turcoale/Bancas2.0/Rough BeagleBone Black.JPG

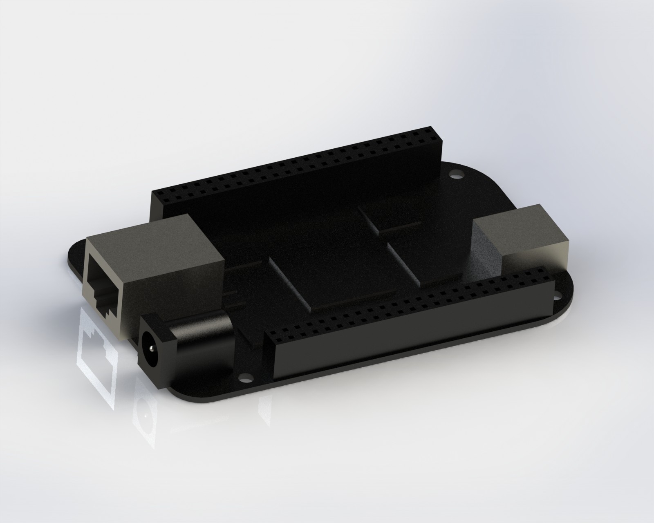
Rough BeagleBone Black.JPG
