turcoale/Bancas2.0/LCD.png

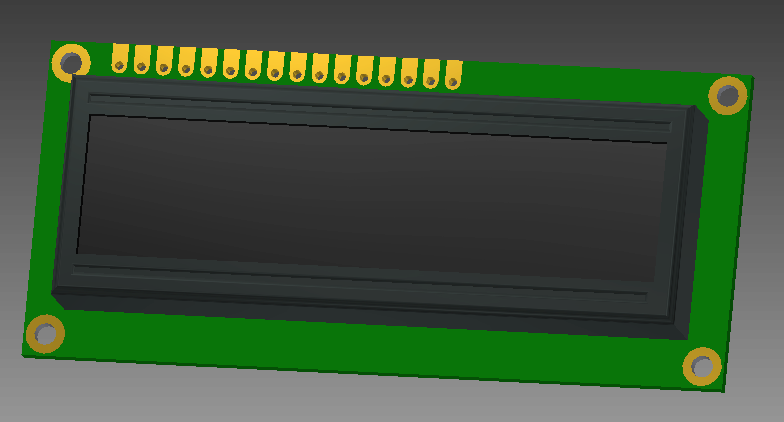
LCD.png
