turcoale/Bancas2.0/Sin título 1.odt

# Modernización y reacondicionamiento de bancas:

Se reemplazará las placas principales de banca por unidades similares pero con tecnología mas actualizada, esto permitirá no sólo realizar un intercambio directo ante eventual falla, sino que también incorporar nuevas funcionalidades para futuras ampliaciones.

Las nuevas placas “MiniPc” poseen un procesador de mayor capacidades a las actuales, puertos usb de propósito general, puertos ethernet, salida de video HDMI, lo cual nos permitirá mas adelante mejorar la topología de conexión de las bancas, ademas de la posibilidad a futuro de incorporar una pantalla tactil de 7” …...
