turcoale/Bancas2.0/166.jpg

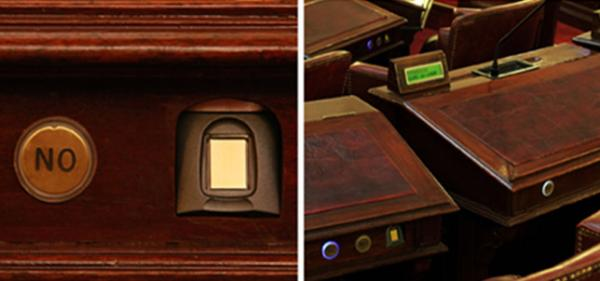
166.jpg
