turcoale/Bancas2.0/BBB.png

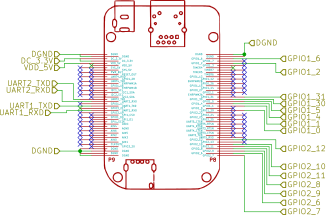
BBB.png
