turcoale/Bancas2.0/biometrico.jpg

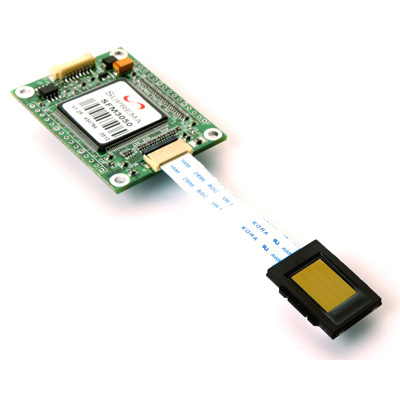
biometrico.jpg
