turcoale/Bancas2.0/butaca.jpg

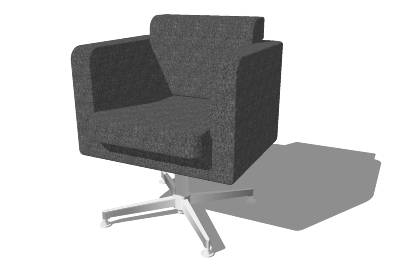
butaca.jpg
