turcoale/Bancas2.0/mic.jpg

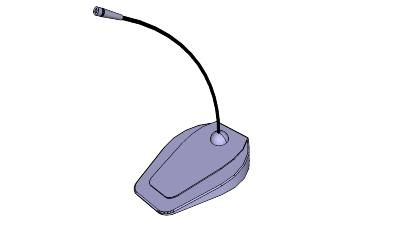
mic.jpg
