turcoale/Bancas2.0/PP.JPG

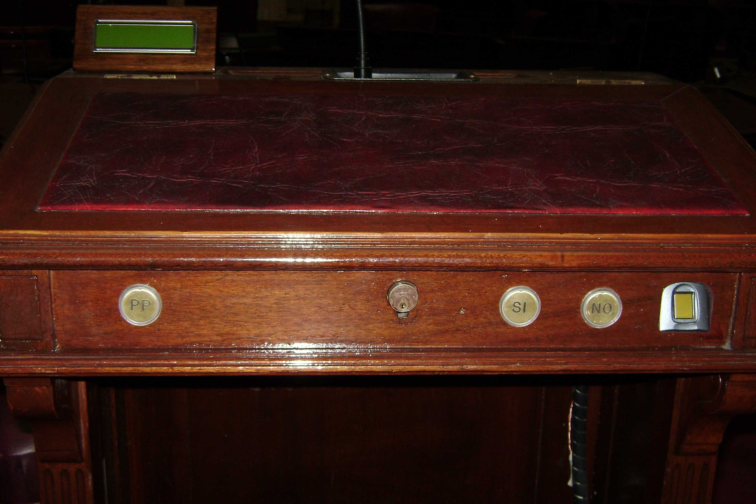
PP.JPG
