turcoale/Bancas2.0/PP.png

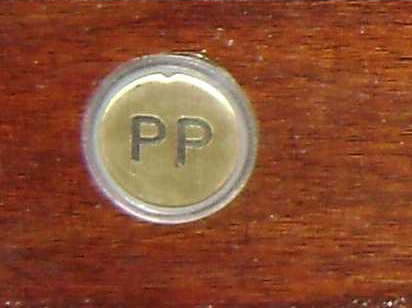
PP.png
