turcoale/Bancas2.0/pulsadores.png

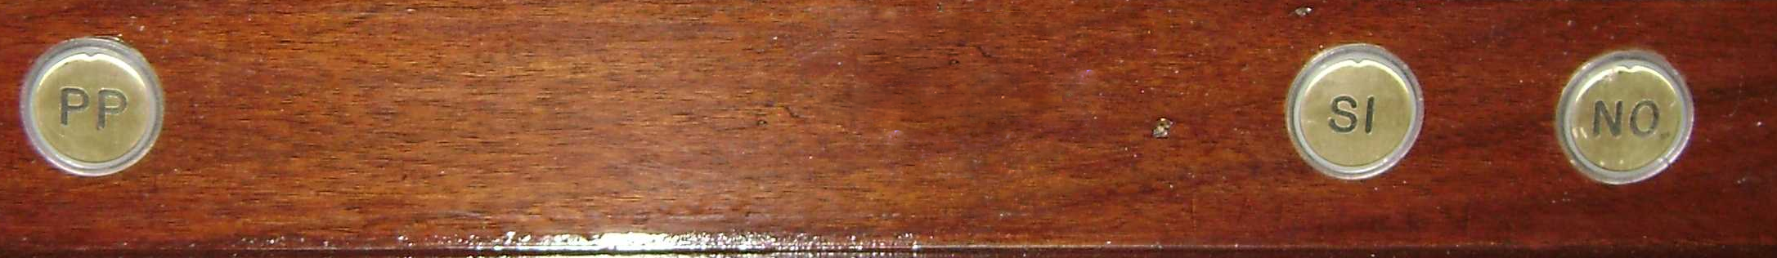
pulsadores.png
