turcoale/Bancas2.0/server.jpg

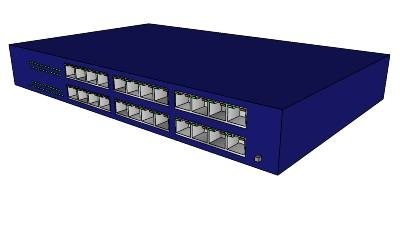
server.jpg
