turcoale/Bancas2.0/Sistema.png

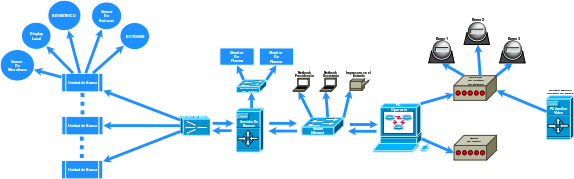
Sistema.png
