turcoale/Bancas2.0/materiales.ods

Insumo | Cantidad | Costos a Enero 2014 | aclaraciones
Placas miniPc BeagleBone Black | 10 | 800
Biometricos Suprema SFM3050 | 4
Placa cape interface | 10
Display 7” | 1 | 2500
Gabinete acrilico o similar para beaglebone | 10 |  | (consultar en acrimec)
cables |  |  | (mejorar el cableado de bancas)
