turcoale/Bancas2.0/diseñopcb/cape/beaglebonecape.pdf

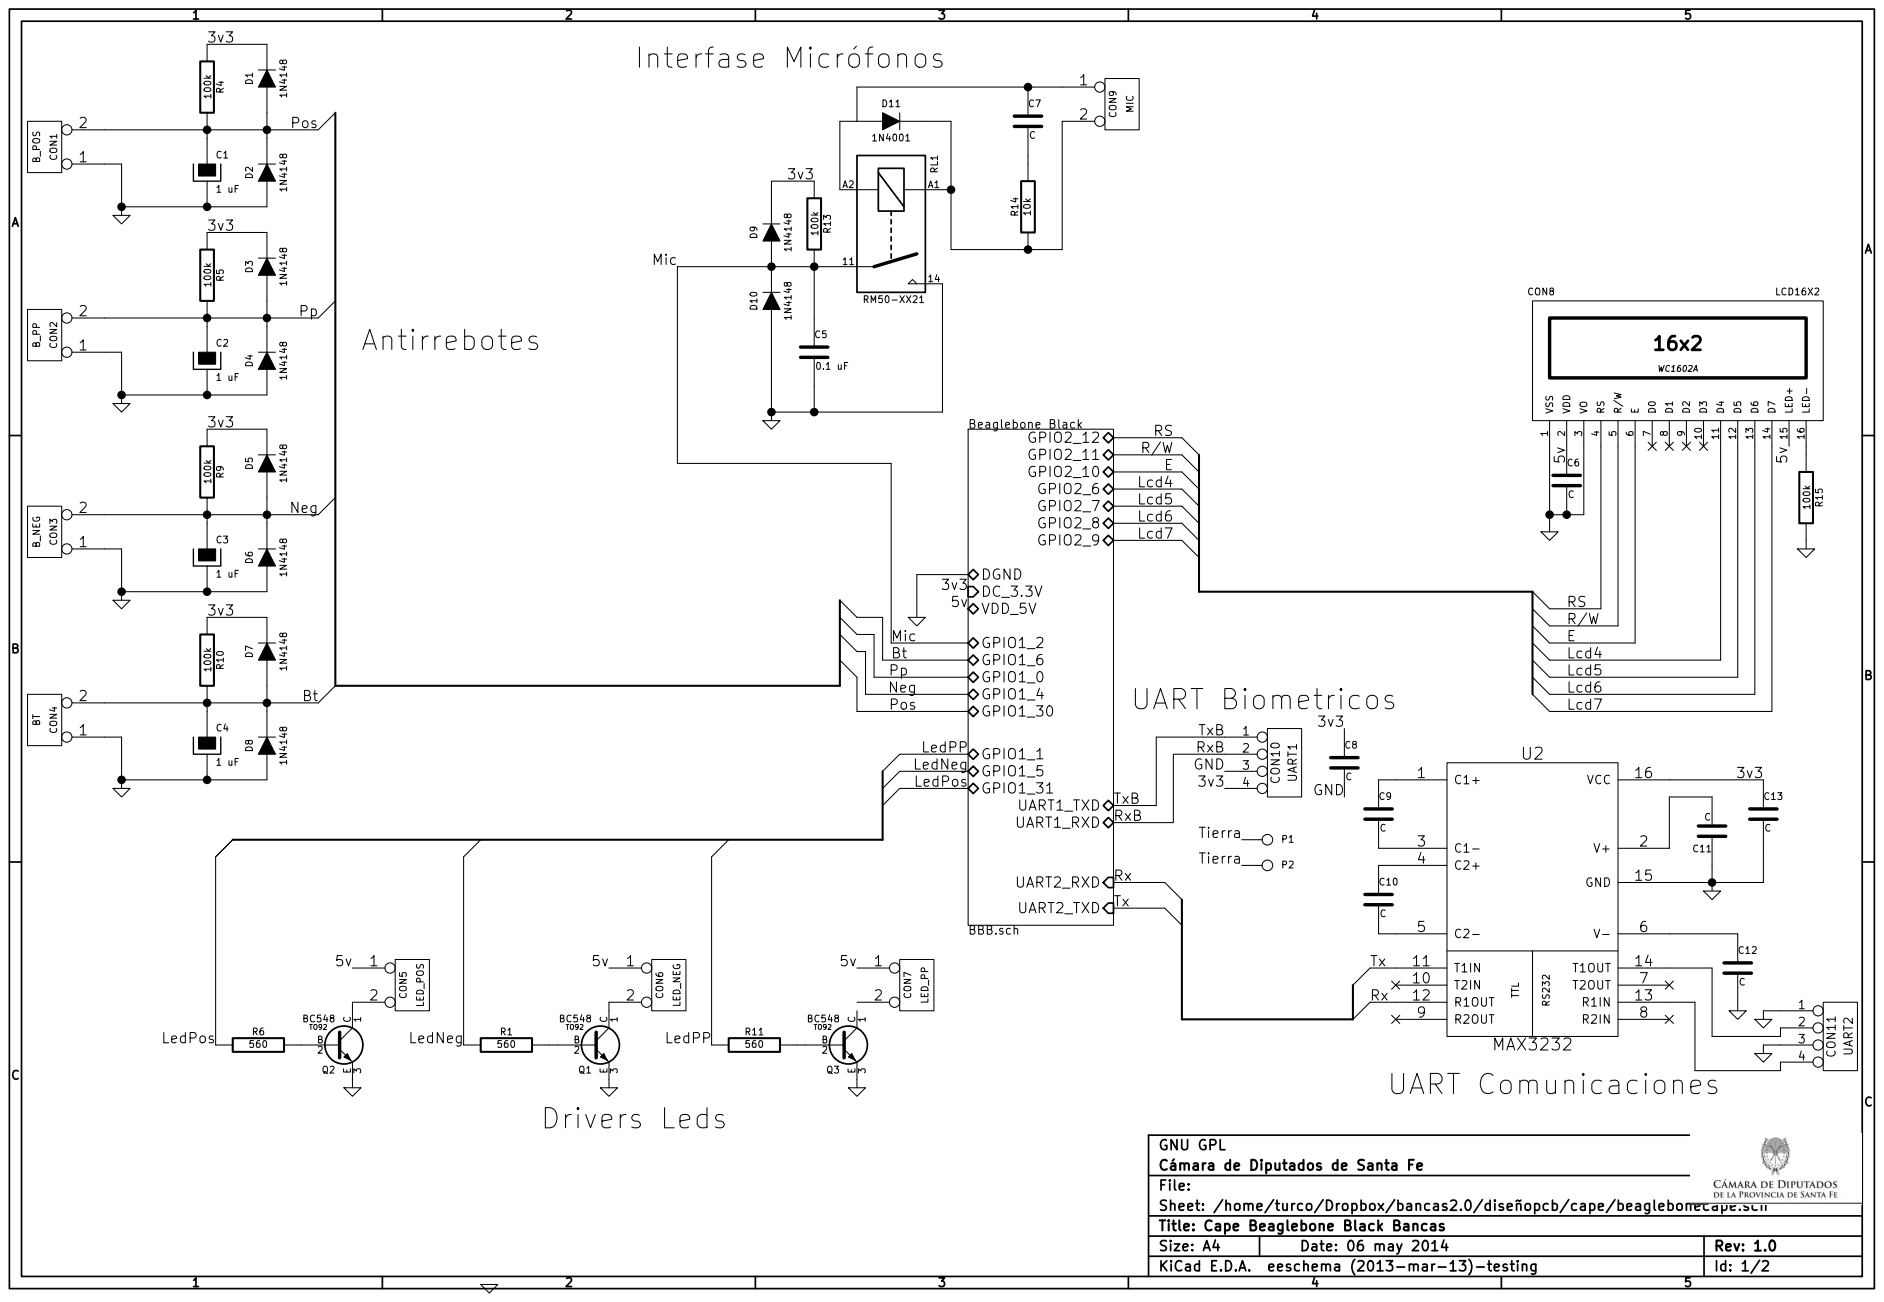
[picture p16: page 1]

9 D3 10 D4 11 D5 12 D6 13 D7 14 LED+ 15 LED- 16 CON8 LCD16X2 WC1602A UART Biometricos

C11C Beaglebone Black BBB.sch DGND

Lcd4
Lcd5
Lcd6
Lcd7

C GNU GPL Cámara de Diputados de Santa Fe

Sheet: /home/turco/Dropbox/bancas2.0/diseñopcb/cape/beaglebonecape.sch File: Title: Cape Beaglebone Black Bancas

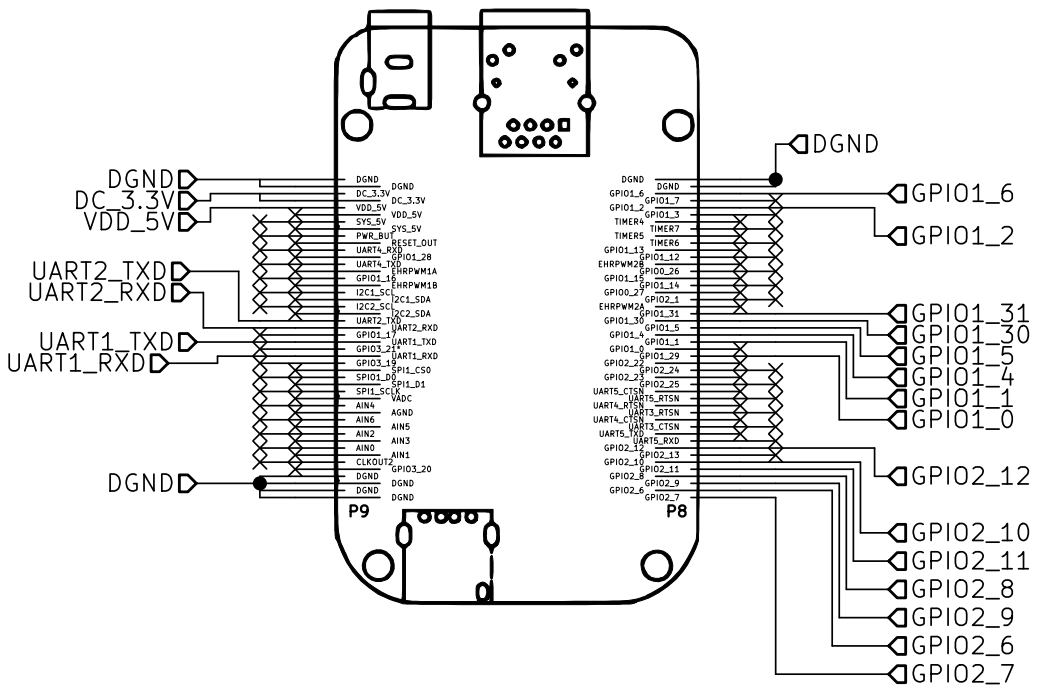
[picture p17: page 2]

C GNU GPL Cámara de Diputados de Santa Fe Sheet: BBB.sch File: Title: Cape Beaglebone Black Bancas
