turcoale/Bancas2.0/diseñopcb/cape/BBB-Beaglebone Black.pdf

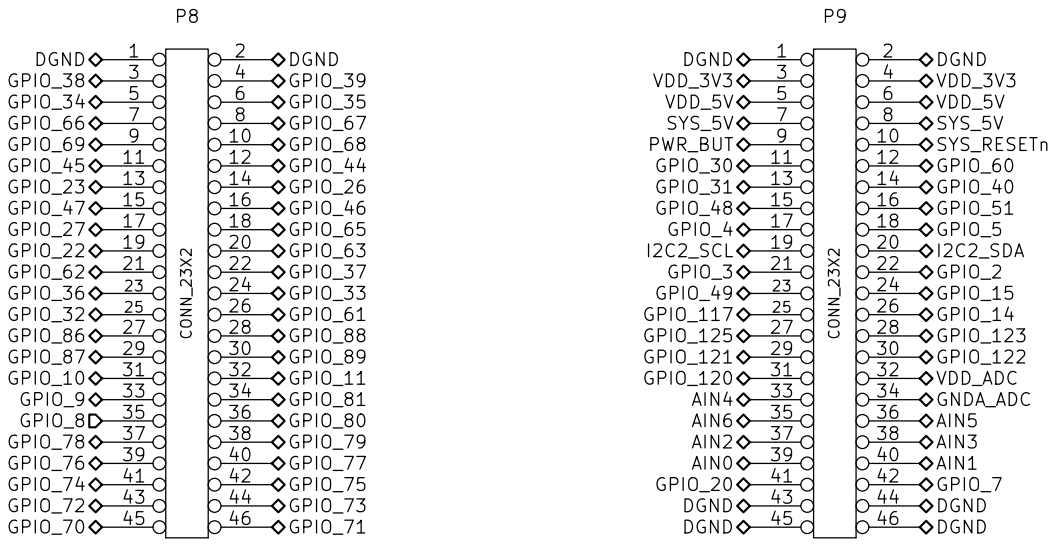
[picture p18: page 1]
