turcoale/Bancas2.0/diseñopcb/cape/beaglebonecape-B_Cu.pdf

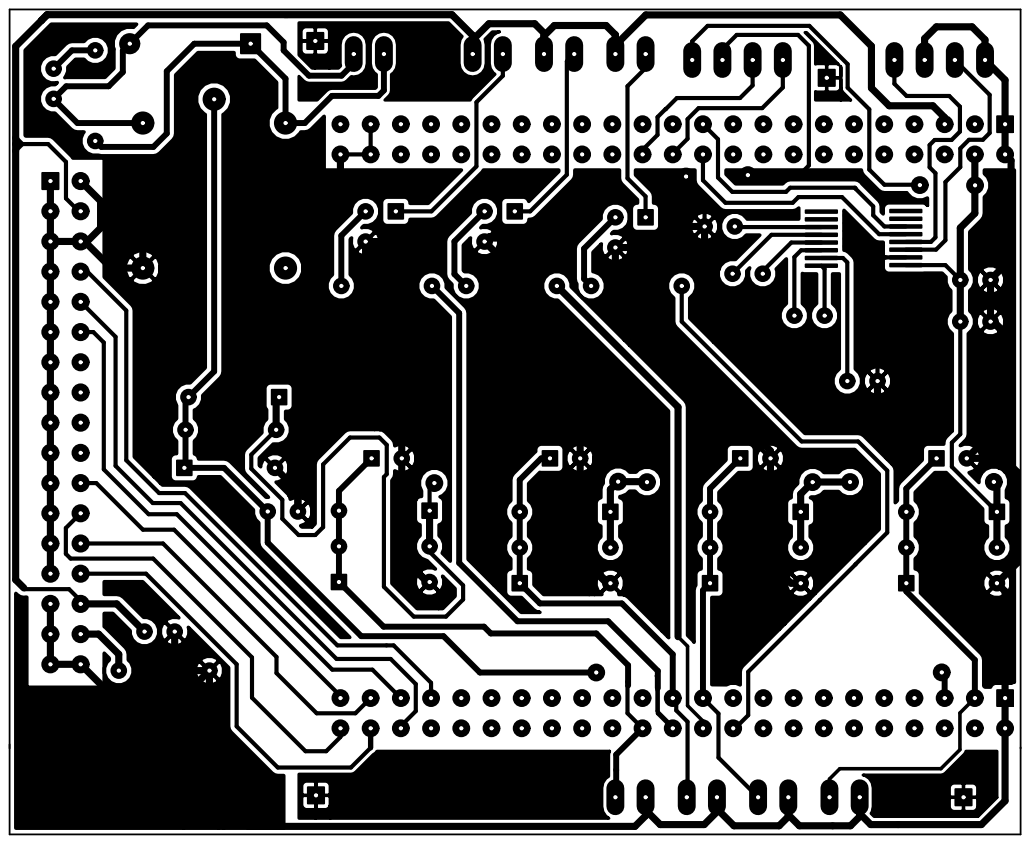
[picture p19: page 1]
