turcoale/Bancas2.0/diseñopcb/cape/beaglebonecape-B_Mask.pdf

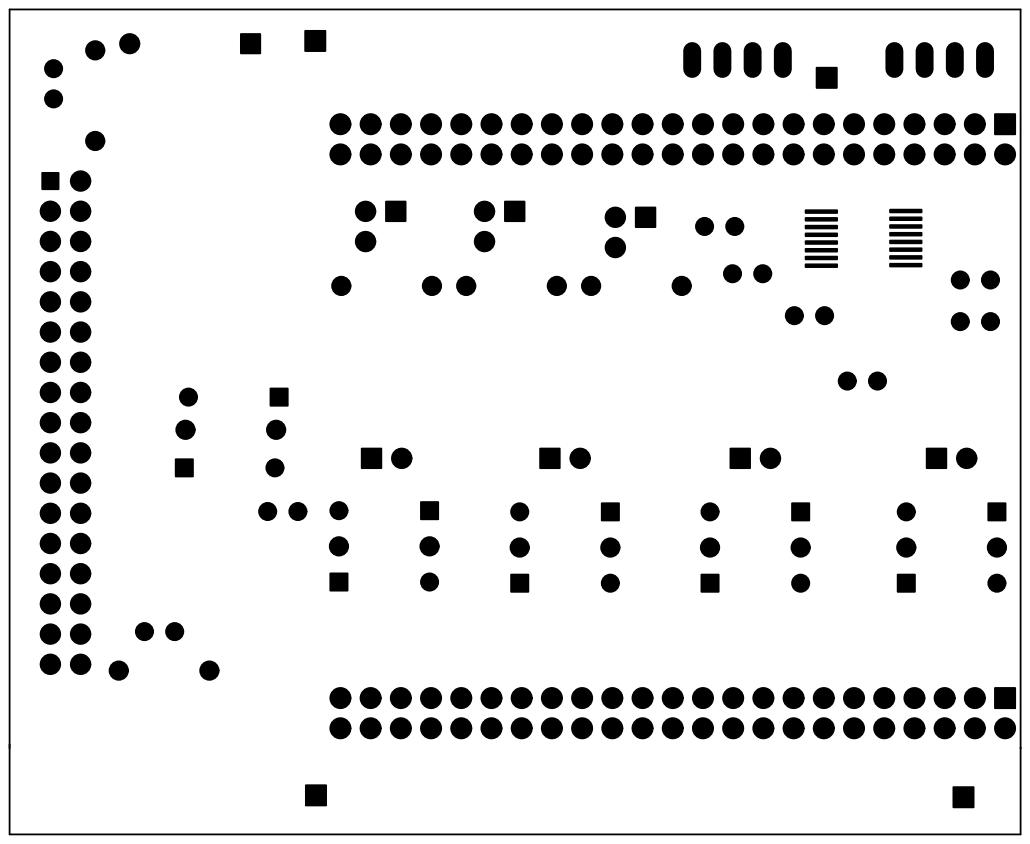
[picture p20: page 1]
