turcoale/Bancas2.0/(commit log)

2014-07-16 subo casi todo
    [BBB.sch, beaglebonecape.csv, beaglebonecape.kicad_pcb, beaglebonecape.sch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]
2014-07-23 descargada libreria para gpio
2014-07-29 lista de pines
    [PinesBbb.ods]
